joris-bakker/EIB-PVS/README.md

# EIB-PVS
Ein Medizinisches Projekt, welches die Oberflächenpotentialverteilung visualisiert
