joris-bakker/EIB-PVS/Präsentationen/Vorstellungspräsentation.pptx

## Projekt: Visualisierung der Oberflächenpotentialverteilung

Joris Bakker Julius Zeng, Luis Klaus, Fakultät ING

## Gliederung

- 1. Visuelle Realisierung des Projektes
- 2. Elektrische Realisierung des Projektes
- 3. Benötigte Komponenten für das Projekt
- 4. Zeitplan

## 1. Visualisierung des Projektes

- - Vorderseite des Torsos Dargestellt
- - Elektronik ist im Bilderrahmen Angebracht
- - Visualisierung der OPV mithilfe von LED-Matrix
- - LED-Matrix ist auf dem Torso angebracht

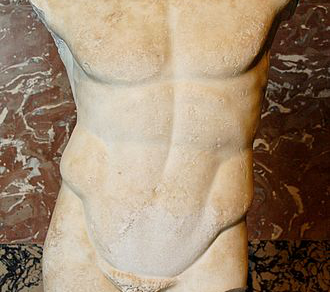
[picture p1: figure]
Ein Bild, das Statue, Artefakt, Kunst, Im Haus enthält.

## 2. Elektrische Realisierung des Projektes

  - - 16x16 LED- Matrix wird mit einem Arduino Angesteuert

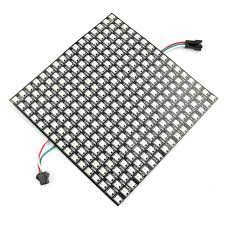
[picture p2: figure]

## 3. Benötigte Komponenten und Geräte

Benötigte Komponente
- Resin
- Mixol
- Trennmittel
- Holz für Rahmen
- LED Matrix
- Netzteil
- Arduino
- Verbindungen (Kabel)
Kosten für Elektronik ca. 60 Euro

  - Benötigte Geräte:
  - - 3D Drucker
  - - CNC Fräse (für Platinen)

## 4. Zeitplan

Woche | Kalenderwoche | Datum | Zielsetzung
2 | 43 | 23.10-29.10 | Gruppenfindung und Projektfindung
3 | 44 | 30.10-05.11 | Vertiefung der Spezifizierung des Projektes
4,5,6 | 45-47 | 06.11-26.11 | Bau des Torsos
6-7 | 47-48 | 13.11-03.12 | Bau und Test der Elektronik
8 | 49 | 04.12-10.12 | Zwischenpräsentation
9,10 | 50 | 11.12-17.12 | Zusammenbau
11-12 | 51-52 | 18.12-31.12 | Puffer

## Quellen

- - https://www.az-delivery.de/products/rgb-led-panel-ws2812b-16x16-256-leds-flexibel-led-modul-5050smd-ic-einzeladressierbare-vollfarbfunktionen-mit-dc5v-kompatibel-mit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
- - https://www.amazon.de/Unbekannt-Mean-DC-Netzteilbaustein-Geschlossen-LRS-50-5/dp/B06XWRCWZ9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
