joris-bakker/EIB-PVS/Anhänge/Stückliste.xlsx

Bezeichnung | Stückzahl/Menge | Preis | Link
Arduino Uno R4 | 1 | 26.50 € | Reichelt (https://www.reichelt.de/arduino-uno-rev4-wifi-ra4m1-esp32-s3-ard-uno-r4-wifi-p353108.html?PROVID=2788)
RGB LED Panel WS2812B 16x16 | 1 | 21.99 € | Webseite (https://www.az-delivery.de/products/rgb-led-panel-ws2812b-16x16-256-leds-flexibel-led-modul-5050smd-ic-einzeladressierbare-vollfarbfunktionen-mit-dc5v-kompati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)
Epoxidharz und Härter | 500g/250g | 17.99 € | Epodex.com (https://www.epodex.com/de/produkt/pro-system/?1=Transparent-farblos)
5V/10A Netzteil | 1
Acrylplatte | 1 | 26.99 € | Amazon.com (https://www.amazon.de/dp/B0BWDDYXWZ?smid=A1LK8FUEKAMIYI&ref_=chk_typ_imgToDp&th=1)
Filament | 626g | 17.95 € | reichelt (https://www.reichelt.de/pla-filament-1-75-mm-tiefschwarz-0-75-kg-m4p-21100211141-p277617.html?PROVID=2788)
