joris-bakker/EIB-PVS/Torso/3D-Objekte/Ständer final.stl

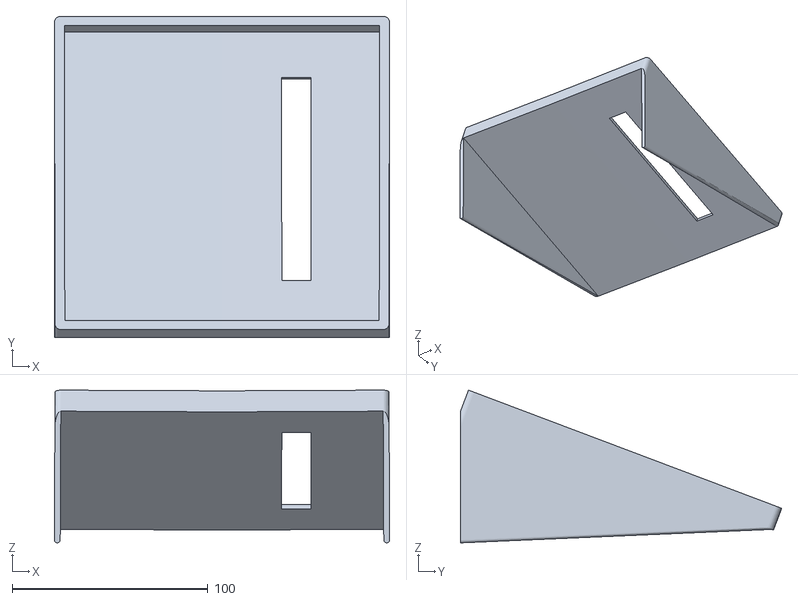
[picture p19: CAD file, 2024-01-24]
Torso/3D-Objekte/Ständer final.stl
171.3 x 164.0 x 78.1
