joris-bakker/EIB-PVS/Torso/3D-Objekte/Frontplatte final.stl

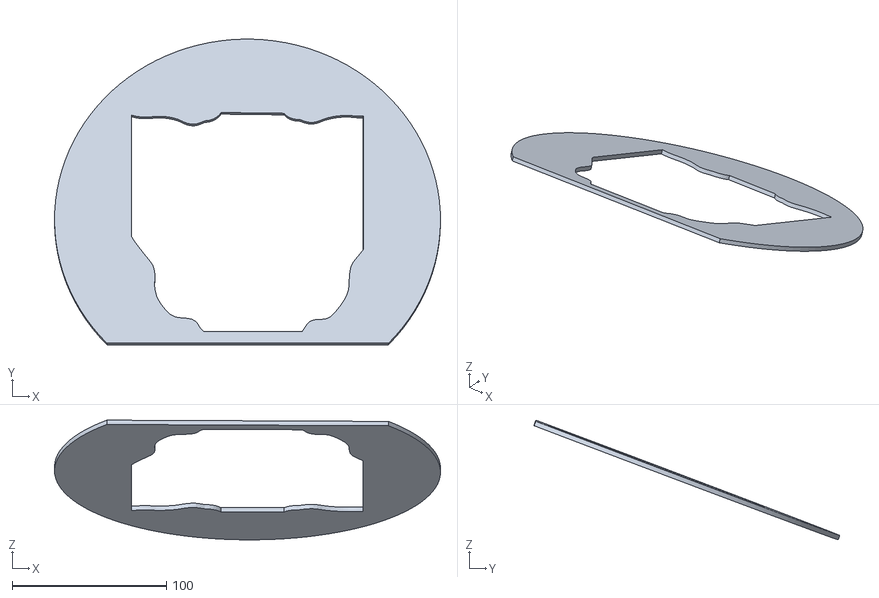
[picture p20: CAD file, 2024-01-24]
Torso/3D-Objekte/Frontplatte final.stl
250.0 x 198.0 x 77.5
