joris-bakker/EIB-PVS/Torso/3D-Objekte/Diffusor final.stl

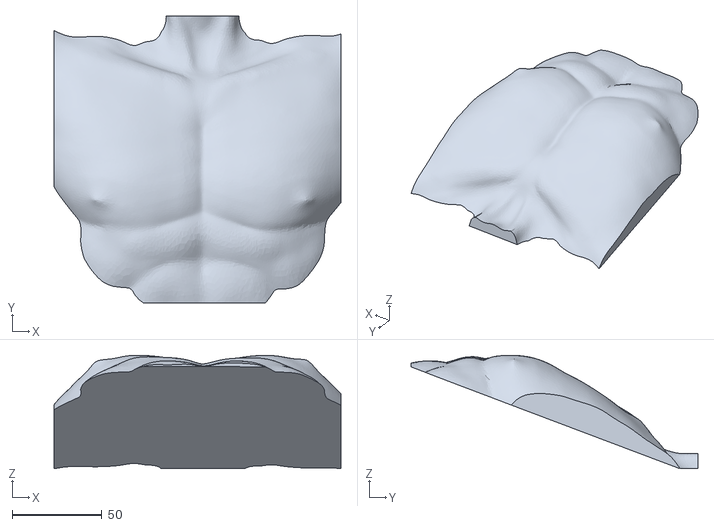
[picture p21: CAD file, 2024-01-24]
Torso/3D-Objekte/Diffusor final.stl
160.0 x 160.0 x 63.3
