joris-bakker/EIB-PVS/Torso/3D-Objekte/Torso diffusor.obj

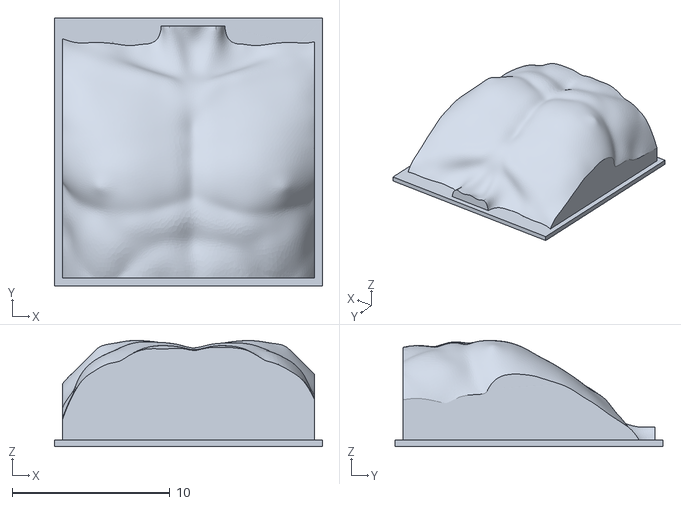
[picture p22: CAD file, 2024-01-23]
Torso/3D-Objekte/Torso diffusor.obj
17.0 x 17.0 x 6.73
