joris-bakker/EIB-PVS/Torso/3D-Objekte/Halterung.obj

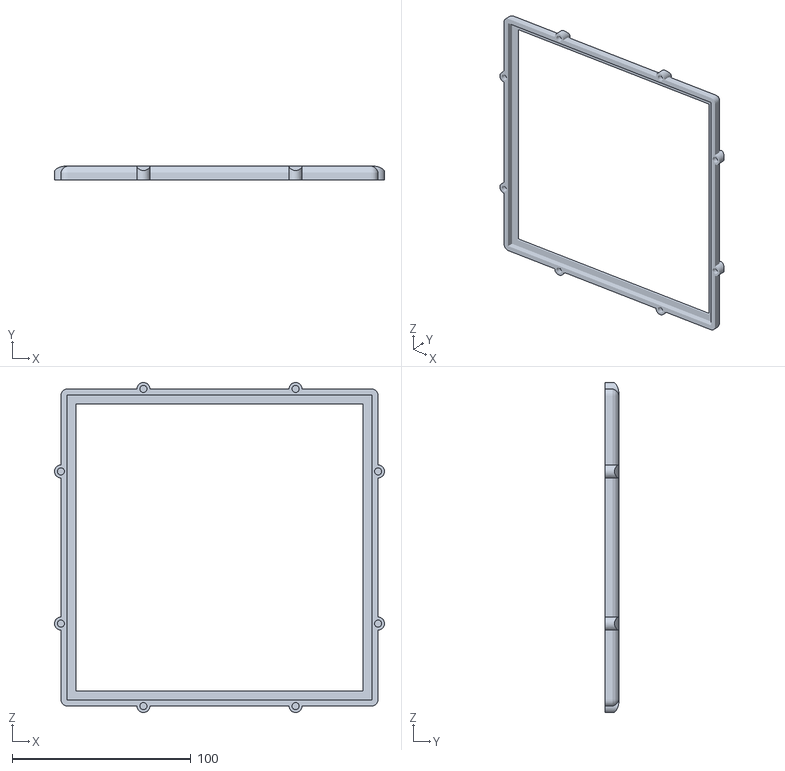
[picture p23: CAD file, 2024-01-23]
Torso/3D-Objekte/Halterung.obj
184.4 x 7.70 x 184.4
