joris-bakker/EIB-PVS/Torso/3D-Objekte/Gussform_Teil_4.stl

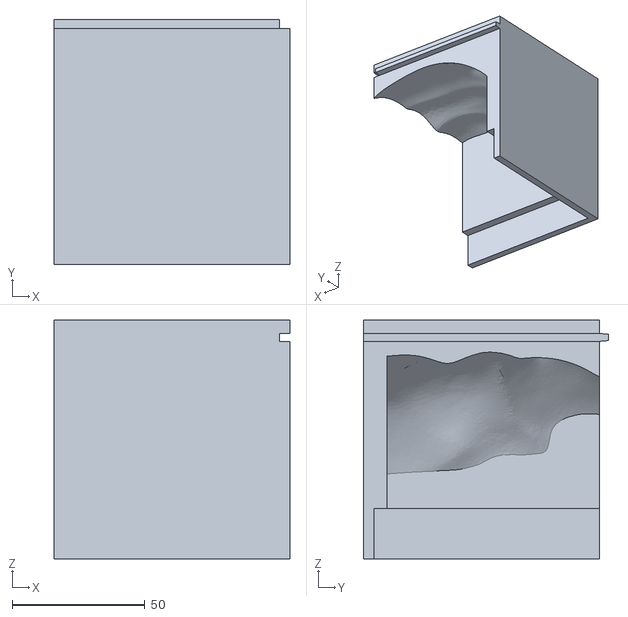
[picture p24: CAD file, 2023-12-30]
Torso/3D-Objekte/Gussform_Teil_4.stl
89.0 x 92.5 x 90.0
