joris-bakker/EIB-PVS/Torso/3D-Objekte/Gussform_Teil_2.stl

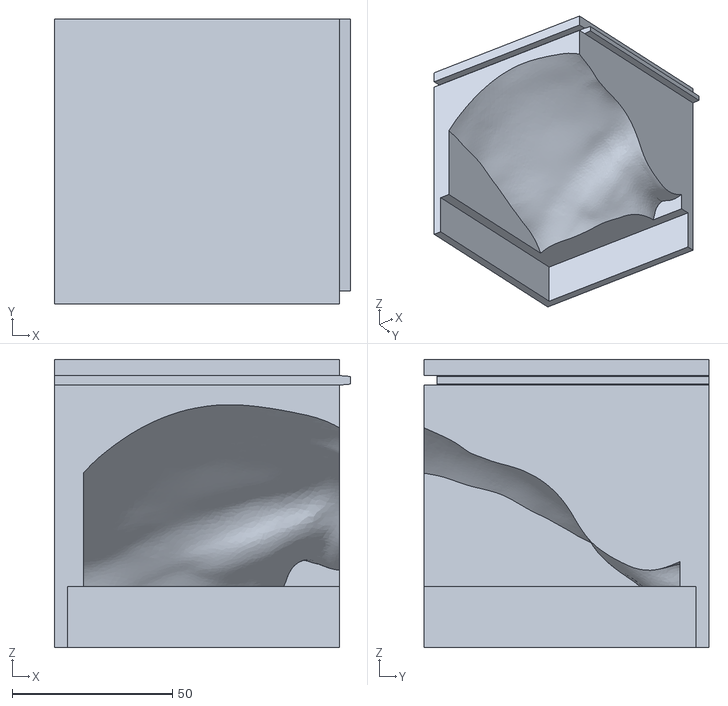
[picture p25: CAD file, 2023-12-30]
Torso/3D-Objekte/Gussform_Teil_2.stl
92.5 x 89.0 x 90.0
