joris-bakker/EIB-PVS/Torso/3D-Objekte/Gussform v7.stl

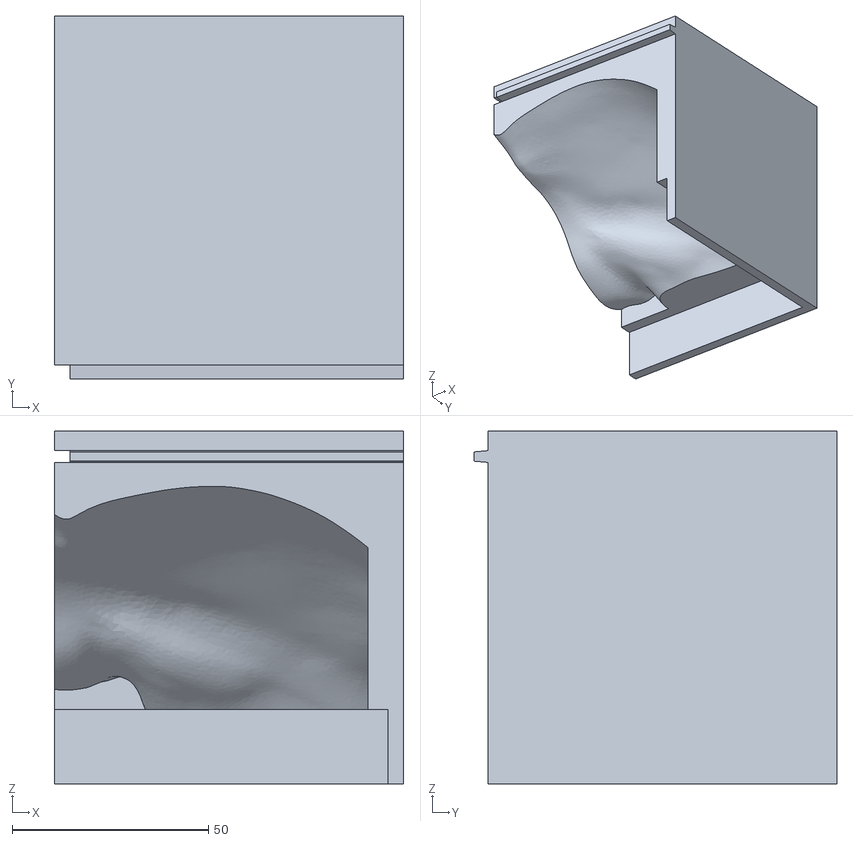
[picture p26: CAD file, 2023-12-30]
Torso/3D-Objekte/Gussform v7.stl
89.0 x 92.5 x 90.0
