joris-bakker/EIB-PVS/Torso/3D-Objekte/Gussform_Teil_1.stl

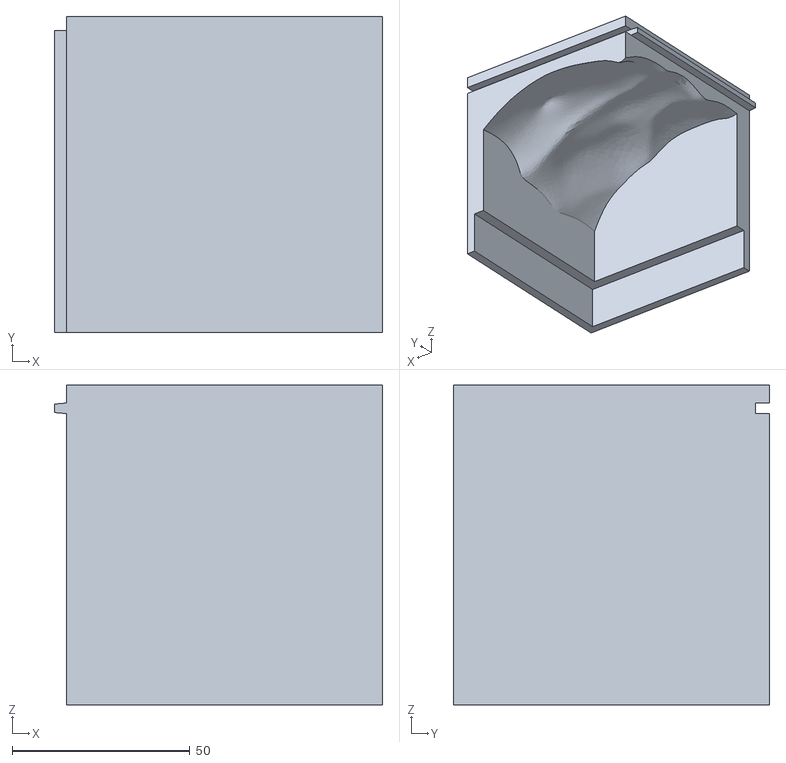
[picture p27: CAD file, 2023-12-30]
Torso/3D-Objekte/Gussform_Teil_1.stl
92.5 x 89.0 x 90.0
