joris-bakker/EIB-PVS/Torso/3D-Objekte/Halterung v1.stl

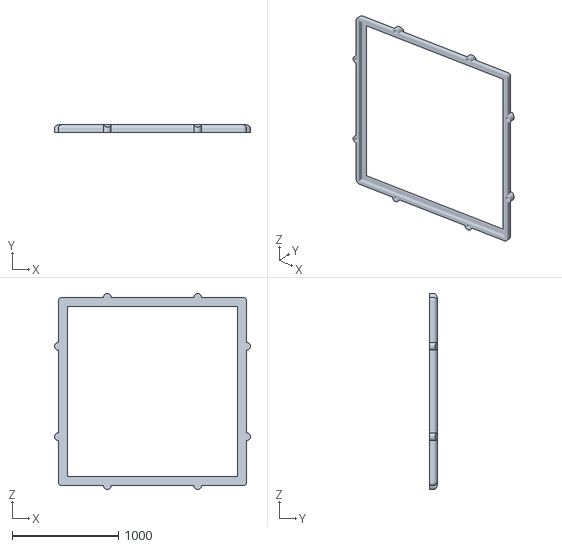
[picture p28: CAD file, 2023-12-04]
Torso/3D-Objekte/Halterung v1.stl
1844.0 x 77.0 x 1844.0
