joris-bakker/EIB-PVS/Torso/3D-Objekte/Torso diffusor v1.stl

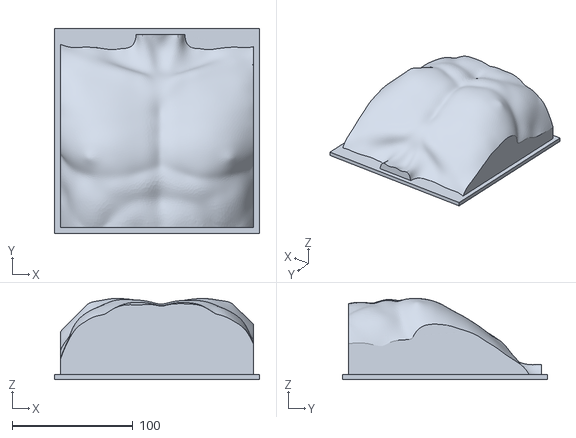
[picture p29: CAD file, 2023-12-04]
Torso/3D-Objekte/Torso diffusor v1.stl
170.0 x 170.0 x 67.3
