joris-bakker/EIB-PVS/Torso/3D-Objekte/Gussform v1.stl

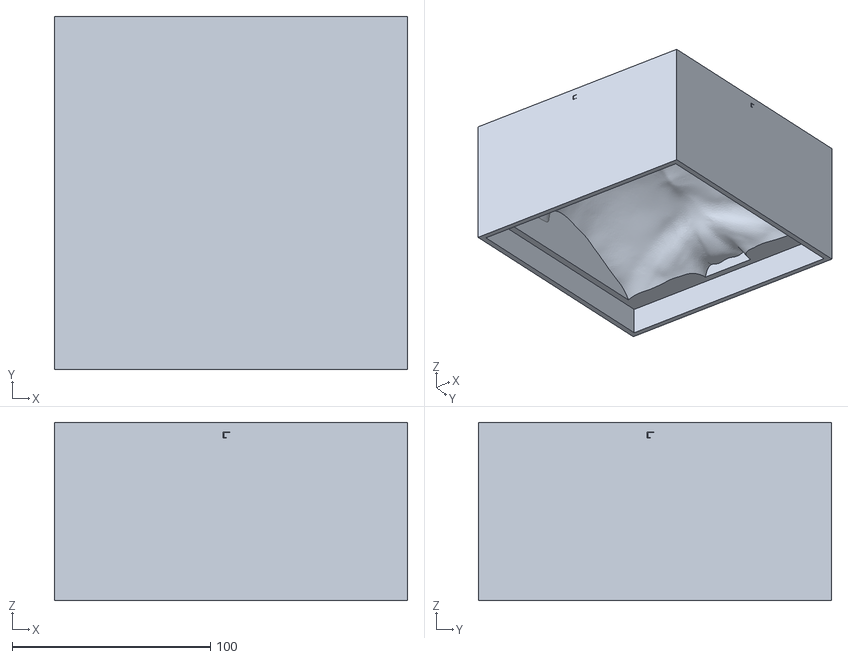
[picture p30: CAD file, 2023-12-30, an earlier design]
Torso/3D-Objekte/Gussform v1.stl
178.0 x 178.0 x 90.0
