joris-bakker/EIB-PVS/Torso/Technische Zeichnungen/Frontplatte.pdf

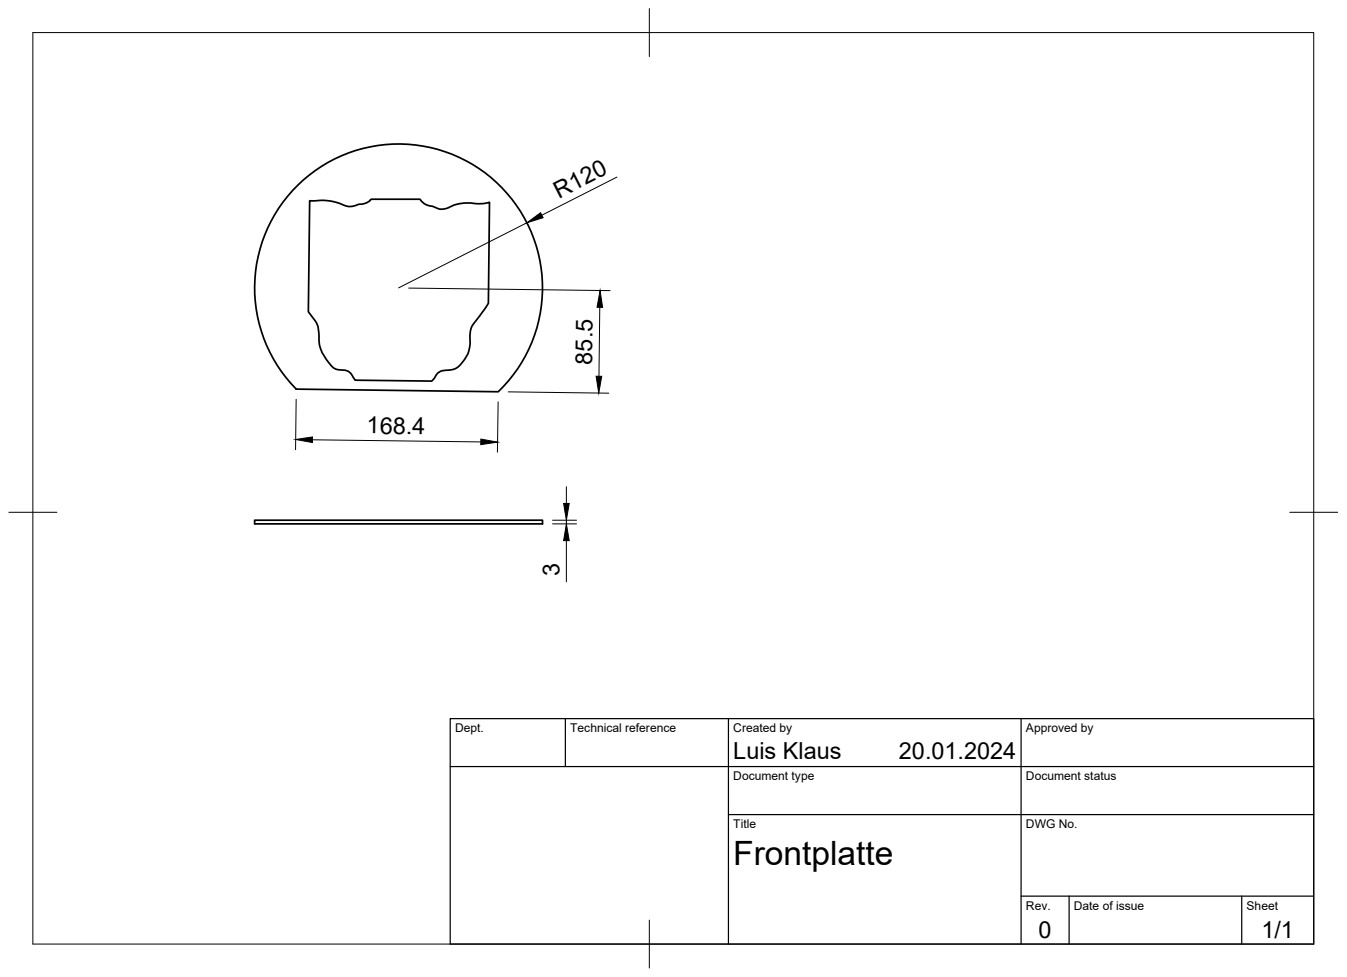
[picture p31: page 1]

Dept. | Technical reference | Created by Luis Klaus 20.01.2024 | Approved by

Document type | Document status

Title Frontplatte | DWG No.

Rev. 0 | Date of issue | Sheet 1/1
