joris-bakker/EIB-PVS/Torso/Technische Zeichnungen/Gesamt.pdf

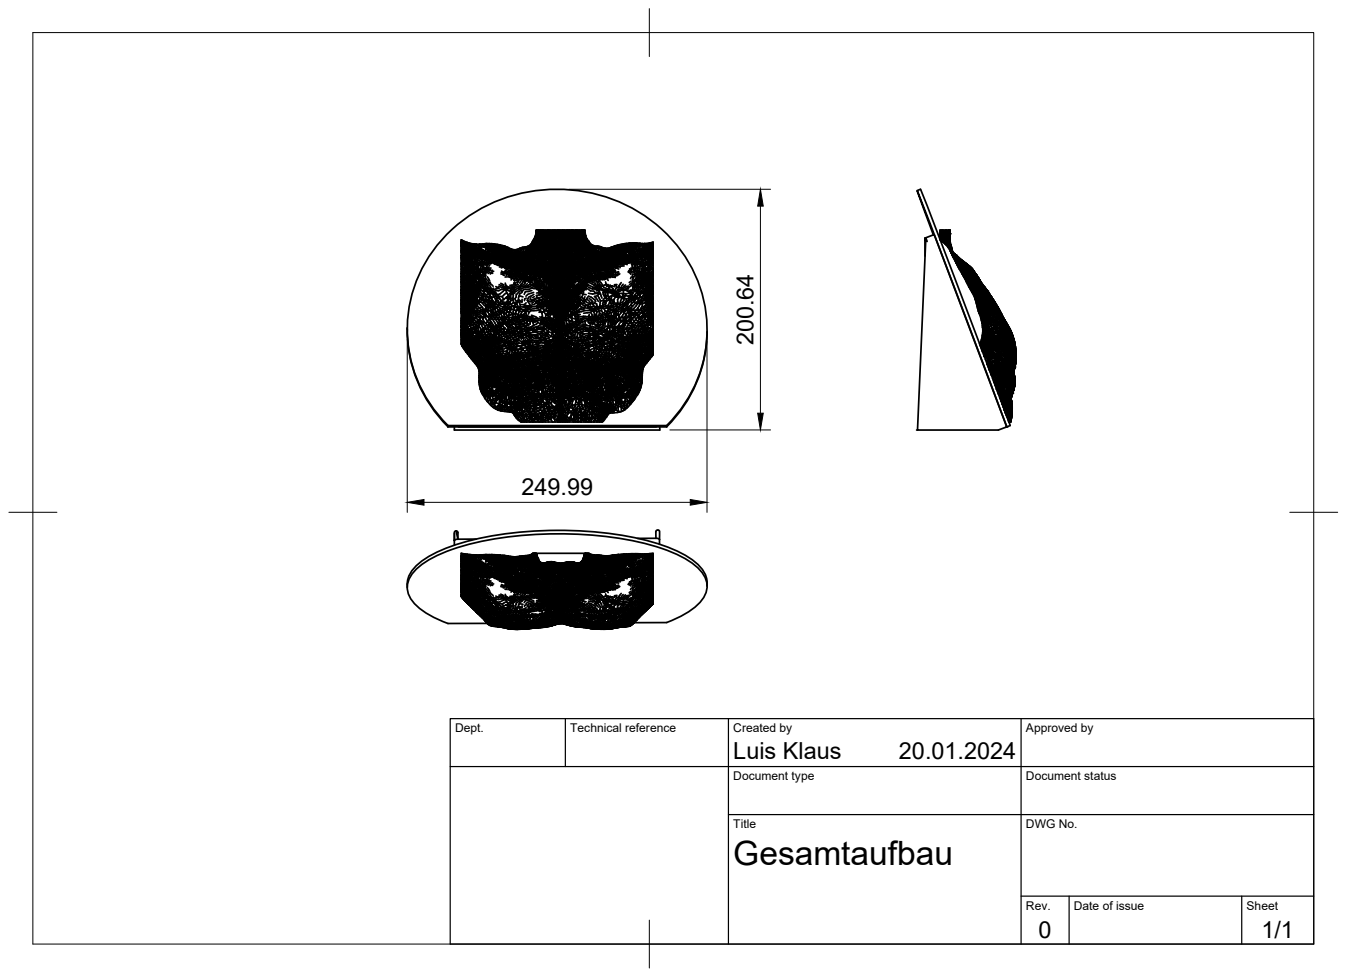
[picture p32: page 1]
Dept.; Technical reference; Created by; Approved by; Document type; Document status; Title; DWG No.; Rev.; Date of issue; Sheet; Luis Klaus 200.64
