joris-bakker/EIB-PVS/Code/BPV_neu.ino

/*      display biopotential distribution on 16x16 rgb led matrix 
        Projekt Medizinische Elektronik WS2023 HTWK Leipzig Prof. Laukner
        Joris Bakker, Julius Zeng, Luis Klaus 20EIB
        (c) Julius Zeng 04.12.2023
*/      
#include <avr/pgmspace.h>     //"write" and read from progmem
#include <FastLED.h>          // official FastLed 3.6.0 release doesnt work (missing uno r4 minima support)
                              // #1523 from facchinm (bit buggy but works) (04.12.2023)--> https://github.com/FastLED/FastLED/tree/0398b9a99901d00044de821ed86e8537995f561b 
#define LED_PIN       5       //5
#define BUTTON_PIN    2       //2
#define COLOR_ORDER   GRB     //GRB     breaks if changed
#define CHIPSET       WS2812B //WS2812B breaks if changed
#define BRIGHTNESS    60      //60 normal, 5 testing, 255 maximum (too bright)
#define MATRIX_WIDTH  16      //16      breaks if changed
#define MATRIX_HEIGHT 16      //16      breaks if changed
#define NUM_LEDS      (MATRIX_WIDTH * MATRIX_HEIGHT)

//##### global constants #####

const int RefreshTime   = 50; //50 ms per frame --> 20FPS (Stable)  [mode 0(potential) --> ~47ms/frame] [mode 1(vector) --> ~11ms/frame]

const double K          = 1;  //1 Lead-Field-Matrix constant
const int rQ            = 5;  //5 radius of Q
const int OffsetxQ      = 3;  //0 center
const int OffsetyQ      = 3;  //0 center
const int fI            = 40; //40 faktor of I

const int TracerLength  = 100;//30 100
const int ModeDefault   = 0;  //unused
const unsigned long TimeDefault = 300000; //Time to change mode (to default) 300000 -> 5min, 60000 -> 1min 

//EKG Data radius,betrag
const float Rad[350]    PROGMEM = {-0.1989096379, -0.1599311478, -0.1099585464, -0.04269711614, 0.05239506231, 0.1891771762, 0.3737521874, 0.5786085734, 0.7419007946, 0.823790367, 0.8326362674, 0.7972301336, 0.7427494824, 0.6838217857, 0.6256208843, 0.5662991542, 0.4975146476, 0.400800397, 0.2350551793, -0.08949824416, -0.6472523364, -1.16166403, -1.424373868, -1.533945144, -1.571001402, -1.572359622, -1.555712178, -1.530571817, -1.502457149, -1.474632801, -1.448938034, -1.426241222, -1.406715994, -1.390018499, -1.375409957, -1.36186314, -1.348193504, -1.333249254, -1.31616267, -1.296603027, -1.274911708, -1.252010989, -1.229092588, -1.207231594, -1.187105631, -1.168904202, -1.152392563, -1.137041582, -1.12215105, -1.106932052, -1.090540971, -1.072065211, -1.050450444, -1.024325029, -0.991580796, -0.9482442735, -0.8847661969, -0.7690693605, -0.3980156239, 1.420297627, 1.939144148, 2.075849095, 2.147822603, 2.196257825, 2.231925645, 2.258806306, 2.278919167, 2.293710578, 2.304463653, 2.312330092, 2.318199906, 2.322532592, 2.325243857, 2.325714338, 2.32294461, 2.315830554, 2.303493871, 2.285591459, 2.262543806, 2.23564844, 2.207060745, 2.179627493, 2.156560765, 2.14095904, 2.135229097, 2.140533653, 2.156456095, 2.18106914, 2.211452678, 2.244468766, 2.27745248, 2.30855882, 2.336732508, 2.361437733, 2.382313054, 2.39886251, 2.410242107, 2.415188304, 2.412154565, 2.399737767, 2.377425952, 2.346513145, 2.310734106, 2.27604887, 2.249420632, 2.237183031, 2.243833464, 2.27151877, 2.31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
CRGB leds[NUM_LEDS];
int TracerMemory[TracerLength]; //memoryarray of vector tracer

//##### conversion functions #####
//(coordinates)
double Xn(byte n){ //returns X value of Dipollocation
  if(n == 1){
    return (xQ1 + OffsetxQ);
  }
  if(n == 2){
    return (xQ2 + OffsetxQ);
  }
}

double Yn(byte n){ //returns Y value of Dipollocation
  if(n == 1){
    return (yQ1 + OffsetyQ);
  }
  if(n == 2){
    return (yQ2 + OffsetyQ);
  }
}

double Xm(byte m){ //returns X value of Output:leds[m]
  byte row = (m / MATRIX_WIDTH);
  if(row % 2){  //row is odd
    return ((((((1+row)*MATRIX_WIDTH)- m)-1)*2)-15);
  }
  else{         //row is even
    return (((m - (row*MATRIX_WIDTH))*2)-15);
  }
}

double Ym(byte m){ //returns Y value of Output:leds[m]
  if(0 <= m <= NUM_LEDS-1){
    return (((m / MATRIX_WIDTH)*2)-15);
  }
}

byte Mxy(double x, double y){ //returns leds[m] value of coordinates (reverse function of Xm/Ym)
  bool reverserow = false;
  byte row    = (y/2)+8;
  byte collum = (x/2)+8;
  if(row % 2){  //row is odd and needs to be reversed
    collum = MATRIX_WIDTH - collum -1;
  }
  return (row * MATRIX_WIDTH + collum);
}

int full2cut(int input){ //converts full coordinates to cut coordinates (-15,-14,-13,-12,... --> -8,-7,-7,-6,...)
  if (input % 2){ //input is odd
    if(input > 0){
      input++;
    }
    else{
      input--;
    }
  }
  return input / 2;
}

int cut2odd(int input){ //converts cut coordinates to odd coordinates (-8,-7,-6,... --> -15,-13,-11,...)
  if(input > 0){
    input = (input*2) - 1;
  }
  if(input < 0){
    input = (input*2) + 1;
  }
  return input; 
}
//(pixel values) Hue:0red 96green 160blue | Sat:  0white 255color | Val(brighness: 0off 255full)
byte Value2Hue(float Value, double MaxValue){ //converts potential value to pixel hue
  float NormValue = abs(Value)/MaxValue;
  if (NormValue > 1){
    NormValue = 1;
  }
  if(Value >= 0){
    return (80 -(NormValue*80));
  }
  else{
    return (80 +(NormValue*80));
  }
}

byte Value2HSValue(float Value, double MaxValue){ //converts potential value to pixel HSValue
  float NormValue = abs(Value)/MaxValue;
    if (NormValue > 1){
      NormValue = 1;
    }
    return (NormValue*255);
}

//##### calculation functions #####

float L(byte m, byte n){ //koeffizient Lead-Field-Matrix (m-ter Messpunkt[0-255] n-ter Quellstrom[0,1])
  return (1/(K*4*PI*sqrt(sq(Xm(m)-Xn(n))+sq(Ym(m)-Yn(n)))));
}

float Potential(byte m){ //returns Potential value of Output:leds[m]
  return (L(m,1)* I1 + L(m,2)* I2);
}

//##### visualisation functions #####

void plotLine(int x0, int y0, int x1, int y1, byte hue){ //plots line between 2 coordinates + hue
  int  dx = full2cut(x1) - full2cut(x0); //int
  int  dy = full2cut(y1) - full2cut(y0); //int
  byte  NPixel;   //number of all Pixels per Line
  byte  NSteps;   //number of steps per Line
  bool    PlotX;
  bool    UpNPixel = false;
  bool    UpNSteps = false;

  if(abs(dx) >= abs(dy)){  //x>y
    //Serial.println("x>y Horizontal");
    NPixel = abs(dx)+1; //+1
    NSteps = abs(dy)+1; //+1
    PlotX  = true;
    if(dx > 0){UpNPixel = true;}
    if(dy > 0){UpNSteps = true;}
  }
  else{                   //y>x
    //Serial.println("y>x Vertikal");
    NPixel = abs(dy)+1; //+1
    NSteps = abs(dx)+1; //+1
    PlotX  = false;
    if(dx > 0){UpNSteps = true;}
    if(dy > 0){UpNPixel = true;}
  }
  int  XNow = full2cut(x0); //int
  int  YNow = full2cut(y0); //int
  byte    PixelNow  = 1;
  byte    StepNow   = 1;
  double  RatioStart  = NPixel/NSteps;
  double  RatioNow;
  byte    StepNrm;  //normal lengh of step
  byte    StepOdd;  //odd lengh of step
  byte    StepLengh;
  byte    NStepsNrm;//number of normal steps per Line
  byte    NStepsOdd;//number of odd steps per Line
  if(NPixel % NSteps){  //--> odd Steps required
    StepNrm = NPixel/NSteps +1;
    StepOdd = StepNrm -1;
  }
  else{                 //--> no odd steps
    StepNrm = NPixel/NSteps;
  }
  for(byte Step = 1; Step <= NSteps; Step++){
    if(PixelNow <= NPixel){  //redundant glaube
      RatioNow = ((NPixel+1) - PixelNow)/(NSteps+1 - Step);
      if((RatioNow/RatioStart)>=1){StepLengh = StepNrm;}
      else{StepLengh = StepOdd;}
      for(byte StepPixel = 1 ; StepPixel <= StepLengh; StepPixel++){
        LedLine = Mxy(cut2odd(XNow), cut2odd(YNow));
        leds[LedLine] = CHSV(hue, 255, 255);
        if(PlotX){
          if(UpNPixel){XNow++;}
          else{XNow--;}
        }
        else{
          if(UpNPixel){YNow++;}
          else{YNow--;}
        }
        PixelNow++;
      }
    }
    if(PlotX){
      if(UpNSteps){YNow++;}
      else{YNow--;}
    }
    else{
      if(UpNSteps){XNow++;}
      else{XNow--;}
    }
    StepNow++;
    RatioNow = ((NPixel-PixelNow) / (NSteps-StepNow));
  }
}

void vectorrad(float betrag, float radwinkel){ //plots vector of given value(betrag 0-1) and angle(rad) //rad = deg * (3.14159265359/180); 
  double r = 100*betrag;
  if(r >= 15){r=15;}
  double xvec = r*cos(radwinkel);
  double yvec = r*sin(radwinkel);
  int xout = xvec;
  int yout = yvec;

  int xstart = 1;
  int ystart = 1;
  if(xvec < 0){
    xstart = -1;
  }
  if(yvec < 0){
    ystart = -1;
  }
  plotLine(xstart,ystart,xout,yout,Value2Hue(betrag,0.7));
}

void tracer(int Led, int hue, int maxval){ //plots fading tracer of leds[m]  maxval is the maxbrightness of tracerled TracerMemory 
  TracerMemory[TracerNow] = Led;
  int TracerMemNow = TracerNow;
  if(maxval <=0 || maxval > 255){
    maxval = 255;
  }
  for(int n = TracerLength; n > 0; n--){
    TracerMemNow--;
    if(TracerMemNow < 0){
      TracerMemNow = TracerLength - 1;
    }
    double multiplyer = n; //double/float needed
    int val = ((maxval - 50) * (multiplyer/TracerLength)) + 50; //-+ offset 
    leds[TracerMemory[TracerMemNow]]  = CHSV( hue, 255, val);
  }
  TracerNow++;
  if(TracerNow >= TracerLength){
    TracerNow = 0;
  }
}

void TracerReset(){ //sets TracerMemory to 0,0
  for(int n = 0; n < TracerLength; n++){
    TracerMemory[n] = Mxy(0,0);
  }
  LedLine = Mxy(0,0);
}

void ShowVector(bool ShowTracer){ //displays vector (with tracer--> true)
  RadFrame = pgm_read_float(&(Rad[Frame]));
  BetFrame = pgm_read_float(&(Bet[Frame]));

  ClearMatrix();
  if(ShowTracer){
    tracer(LedLine,160,100);
  }
  vectorrad(BetFrame, RadFrame);
  FastLED.show();
}

void ShowPotential(){ //displays potential
  RadFrame = pgm_read_float(&(Rad[Frame]));
  BetFrame = pgm_read_float(&(Bet[Frame]));

  xQ1 = rQ * sin(RadFrame);
  xQ2 = xQ1 * -1;
  yQ1 = rQ * cos(RadFrame);
  yQ2 = yQ1 * -1;
  I1  = fI * BetFrame;
  I2  = I1 * -1;
  float PotFrame;
    
  for (int x = 0; x < NUM_LEDS; x++){
    PotFrame = Potential(x);
    leds[x] = CHSV(Value2Hue(PotFrame,0.15), 255, Value2HSValue(PotFrame,0.05));
  } 
  //vectorrad(BetFrame, RadFrame);
  FastLED.show();
}

void NextFrame(int add){ //1   advances to the next frame (input is added to current frame number) 
  Frame = Frame +add;
  if(Frame >= 350){
    Frame = 0;
  }
}

void ClearMatrix(){ //sets all matrix values to 0
  for (int x = 0; x < NUM_LEDS; x++)
  {
    leds[x]= 0x000000;;
  }
}

void ChangeMode(){ //changes current mode if button is pressed or timed
  if(digitalRead(2) == 0){
    ModeChanged = true;
    Mode++;
    if(Mode >= 2){
      Mode = 0;
    }
    delay(500);
  }
  /* automatic mode change after time
  if(millis() - ModeTime >= TimeDefault){
    ModeChanged = true;
    Mode++;
    if(Mode >= 2){
      Mode = 0;
    }
    delay(500);
  }
  */
}

void setup() {
  pinMode(2, INPUT_PULLUP);
  FastLED.addLeds<CHIPSET, LED_PIN, COLOR_ORDER>(leds, NUM_LEDS).setCorrection(TypicalSMD5050);
  FastLED.setBrightness( BRIGHTNESS );
  //Serial.begin(9600);
  //Serial.println("end setup");
}

void loop(){
  while(Mode == 0){ //potential
    if(ModeChanged){
      ModeTime = millis();
      ModeChanged = false;
    }
    if(NewRefresh){
      Time = millis();

      ShowPotential();
      NextFrame(1);

      //Serial.println(millis() - Time); // Time to process and show Frame
      NewRefresh = false;
    }
    if(millis() - Time >= RefreshTime){
      NewRefresh = true;
    }
    ChangeMode();
  }
  while(Mode == 1){ //vector
    if(ModeChanged){
      TracerReset();
      ModeTime = millis();
      ModeChanged = false;
    }
    if(NewRefresh){
      Time = millis();

      ShowVector(true);
      NextFrame(1);

      //Serial.println(millis() - Time); // Time to process and show Frame
      NewRefresh = false;
    }
    if(millis() - Time >= RefreshTime){
      NewRefresh = true;
    }
    ChangeMode();
  }
}
