joris-bakker/EIB-PVS/(commit log)

2023-10-26 Sachen von Matthias
    Hab die sachen aus der Vorlesung reingefügt
2023-11-29 Add files via upload
    Halterung für den Torsodiffusor
    [Halterung.obj]
2023-11-29 Add files via upload
    Torsodiffusor
    [Torso diffusor.obj]
2023-12-04 STL dateien
    mit Stl dateien
    [Halterung v1.stl, Torso diffusor v1.stl]
2023-12-30 stl einzelfiles
    [Gussform v1.stl, Gussform v7.stl, Gussform_Teil_1.stl, Gussform_Teil_2.stl, Gussform_Teil_3.stl, Gussform_Teil_4.stl]
